htlabnet/DRSSTC_SFP_Transceiver_For_v1/(commit log)

2020-11-17 ModelSIm用スクリプトファイル追加
2020-11-23 Master側の送信機能を仮実装
2020-11-23 snake case
2020-11-28 K28.5コード挿入機能追加
2020-11-28 Optionビットの並び修正
2020-11-28 MOSIデータの送受信に対応
2020-11-28 Revert "Create tb_pattern_gen.v"
    This reverts commit 6cde7ce701387be34c47044b50948cc8e769701e.
    [tb_pattern_gen.v]
2020-11-28 Revert "Revert "Create tb_pattern_gen.v""
    This reverts commit 0b42c77d0a3cfd59bfd0b0bf546f2ad1ff70bfe1.
    [tb_pattern_gen.v]
2020-11-29 奇数パリティに変更
2020-11-29 起動シーケンス（LEDチェック）追加
2021-09-18 SFP LOS信号の検出機能追加
    LOS信号がアサートされている場合（SFPの受光信号が弱い場合）は、シンボルロック状態を強制解除し、RawPlsをLowにするよう変更
2021-09-18 コード記述順序入れ替え（機能影響なし）
2021-09-18 8b10bコードエラーでアンロック
    8b10bコードエラー検出時にアンロック状態へ遷移するように修正
2023-10-16 20Mbps対応
2023-10-16 Update serial_rx.v
    エラー時にOptionも0クリアする動作に変更
2023-10-20 良い感じに動作
2023-10-20 Add PCB image
